astrolabe-expeditions/LittObs_CTD/docs/README.md

# LittObs | Sonde CTD

## Description

Le programme LittObs d’Astrolabe Expeditions a pour objectif de déployer un réseau d’observatoires océanographiques littoraux en impliquant les habitants du territoire. Ces observatoires sont des stations de mesure lestées au fond de l’eau qui enregistrent les paramètres physiques, chimiques ou biologiques de la colonne d'eau. Les premiers capteurs seront chargés de mesurer la conductivité, la température et la pression de l'eau (CTD) afin de déterminer la salinité de l'eau.

## Partenaires

* [LOCEAN](https://www.locean.ipsl.fr/) (IRD/Sorbonne Université)
* [LOPS](https://www.umr-lops.fr/) (CNRS/Ifremer/IRD/IUEM/UBO)
* [AMURE](https://www.umr-amure.fr/) (IUEM/UBO)
* [Les Fabriques du Ponant](https://www.lesfabriquesduponant.net/)
* Amicale des plaisanciers des Marinas de Brest (APMB)
* Association des plaisanciers de Sainte-Anne du Portzic (APSAP)
* [Réseau Initiatives des Eco-explorateurs de la Mer](https://riem-asso.com/) (RIEM)
* [Fondation du Crédit Mutuel Alliance Fédérale](https://fondation.creditmutuelalliancefederale.fr/)
* [Fondation de France](https://www.fondationdefrance.org/)

## Étudier les zones littorales sous l'influence des fleuves

Les zones littorales, directement influencées par les apports fluviaux, sont intéressantes dans l’étude du mélange entre les eaux douces et marines, facteur important de la salinisation des océans, et donc des mouvements des courants marins qui régulent notre climat. De plus, la biodiversité marine et terrestre y est plus dense que sur le reste du littoral, favorisant le développement d’écosystèmes riches et particuliers. Ces zones sont aussi vulnérables puisque soumises à la pression liée à l’activité humaine ainsi que par le changement climatique. Il est donc primordial de surveiller l’évolution de ces écosystèmes à des fins de préservation. L’opportunité de développer des capteurs à bas coût, construits et déployés localement pourrait augmenter significativement la compréhension de ces mélanges entre continents et mers, et d’apporter des jeux de données accessibles sur la courantologie côtière permettant d’anticiper les effets du réchauffement climatique.

## Matériel&#x20;

| Sous-total ligne de mouillage avec LAMOS (TTC) | | | 544,02 € |
| --- | --- | --- | --- |
| [Caisson CTD](./module-2-caisson-ctd.md) | | | |
| 0,25 | [Plaque plexiglass épais. 10mm transparent, L. 50cm x H. 30cm](https://plaqueplastique.fr/product/plaque-plexiglass-xt-10mm-transparent/) | 21,59 €  | 5,40 € |
| 2 | [Joint torique, Ø int. 52mm, Ø ext. 60mm, épais. 4mm](http://fr.rs-online.com/web/p/joints-et-joints-toriques/1965129) | 0,45 € | 0,90 € |
| 1 | [Joint torique, Ø int. 12mm, Ø ext. 16mm, épais. 2mm](https://fr.rs-online.com/web/p/joints-et-joints-toriques/1964869?gb=a) | 0,10 € | 0,10 € |
| 3 | [Écrou borgne M4, inox A4 316](https://www.vis-express.fr/ecrou-borgne-inox-a4-din-1587-vs0100/37773-2559648-ecrou-borgne-m4-inox-a4.html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) | 0,04 € | 0,11 € |
| 3 | [Écrou à oreilles M4, inox A4 316](https://fr.rs-online.com/web/p/ecrous-a-oreilles/2484315?gb=s) | 0,79 € | 2,36 € |
| 2 | [Vis à tête cylindrique pozi M3 x L. 20mm, inox A4 316](https://fr.rs-online.com/web/p/vis-a-metaux/0190478?gb=s) | 0,13 € | 0,25 € |
| 6 | [Vis à tête cylindrique pozi M3 x L. 10mm, inox A4 316](https://fr.rs-online.com/web/p/vis-a-metaux/0190440?gb=s) | 0,10 € | 0,62 € |
| 1 | [Tige filetée M4 x L. 1m, inox A4 316](https://www.vis-express.fr/tige-filetee-longueur-1-metre-inox-a4-din-975vs3347vs0104/21608-tige-filetee-m4-longueur-1-metre-inox-a4.html) | 1,92 € | 1,92 € |
| 1 | [Tube PVC PN16, Ø ext. 63mm, épais. 4,7mm](https://connexion-pression.com/tubes-rigides-pvc-pression/63-915-tube-d-63-pn16-pvc-pression.html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) | 12,31 €  | 12,31 € |
| 4 | [Colliers de serrage nylon 4,8mm x 300mm](https://fr.rs-online.com/web/p/serre-cables/0233487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) | 0,15 € | 0,58 € |
| 0,1 | [Filament 3D PETG 1kg noir 1,75 mm](https://eu.store.bambulab.com/fr/products/petg-hf?id=49068714754396) | 25,99 €  | 2,60 € |
| 2 | [Vis à tête hexagonale M8 x L. 40mm, inox A4 316](https://www.vis-express.fr/vis-metaux-tete-hexagonale-th-inox-a4-din-933/20979-2322303-vis-metaux-tete-hexagonale-th-m8x40-inox-a4.html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..\&gclid=Cj0KCQiA_NC9BhCkARIsABSnSTarAGtmwjGLn0YNz8O_tkDtvD-51bRM3g7qLIVmRQDK-fGx2-1gUb4aAhp9EALw_wcB#/conditionnement-30_pieces) | 1,56 € | 3,12 € |
| 0,1 | [Graisse silicone pour joints toriques](https://fr.rs-online.com/web/p/graisses/0494124) | 18,23 €  | 1,82 € |
| | Imprimante 3D (pour support PCB et fixation CTD) | | |
| | Découpeuse laser | | |
| | Perceuse à colonne (avec foret à acier) | | |
| | Lime à métaux | | |
| | Scie sauteuse (avec lame à métaux) | | |
| | Tarauds | | |
| | Scie circulaire | | |
| | Affleureuse | | |
| [PCB CTD](./module-1-carte-electronique-pcb.md) | | | |
| 1 | [PCB à imprimer](https://jlcpcb.com/) | 3,00 € | 3,00 € |
| 1 | [Mini Conductivity Probe K 1.0](https://sensorsandprobes.com/products/mini-conductivity-probe-k-1-0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) | 109,95 € | 109,95 € |
| 1 | [Electrically Isolated EZO™ Carrier Board](https://sensorsandprobes.com/products/electrically-isolated-ezo%E2%84%A2-carrier-board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) | 32,95 €  | 32,95 € |
| 1 | [EZO™ Conductivity Circuit](https://sensorsandprobes.com/products/ezo%E2%84%A2-conductivity-circuit?_pos=1&_sid=2aabb4a1c&_ss=r) | 67,95 €  | 67,95 € |
| 1 | [Booster 5 V U1V11F5](https://www.gotronic.fr/art-booster-5-v-u1v11f5-21751.htm) | 8,80 € | 8,80 € |
| 1 | BlueRobotics Celsius Fast-Response, ±0.1°C Temperature Sensor (I2C) | 78,66 €  | 78,66 € |
| 1 | [BlueRobotics Bar30 High-Resolution 300m Depth/Pressure Sensor](https://eu.robotshop.com/products/bar30-high-resolution-300m-depth-pressure-sensor-r2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) | 98,18 €  | 98,18 € |
| 1 | [Module FireBeetle ESP32 DFR0478](https://www.gotronic.fr/art-module-firebeetle-esp32-dfr0478-26810.htm) | 13,90 €  | 13,90 € |
| 1 | [Cordon USB micro USB 50cm](https://www.gotronic.fr/art-cordon-50-cm-rs105-33657.htm) | 1,95 € | 1,95 € |
| 1 | [Lecteur de carte micro-SD ADA4682, interface SPI et SDIO, 3,3 Vcc](https://www.gotronic.fr/art-lecteur-de-carte-micro-sd-ada4682-33468.htm) | 4,55 € | 4,55 € |
| 1 | [Carte MicroSDHC 8GB avec adaptateur](https://fr.rs-online.com/web/p/cartes-sd/2835980) | 6,76 € | 6,76 € |
| 1 | [Module RTC I2C DS3231M DFR0641](https://www.gotronic.fr/art-module-rtc-i2c-ds3231m-dfr0641-32243.htm) | 8,25 € | 8,25 € |
| 1 | Pile 3V CR1220 | 1,70 € | 1,70 € |
| 2 | [Batterie 18650 3400mAh 8A (/!\ la référence change régulièrement)](https://www.nkon.nl/fr/samsung-inr18650-35e.html) | 2,29 € | 4,58 € |
| 2 | [Support batterie 18650](https://www.nkon.nl/fr/1x-18650-batterijhouder-met-klemmen-en-losse-draden.html) | 1,09 € | 2,18 € |
| 1 | [Led 5mm verte 2 mA](https://www.gotronic.fr/art-assortiment-de-50-leds-36117.htm) | 0,10 € | 0,10 € |
| 1 | [Résistance 1/4W 47Ω](https://www.gotronic.fr/art-10-resistances-1-4w-47-8486-2561.htm) | 0,02 € | 0,02 € |
| 2 | [Résistance 1/4W 4,7KΩ](https://www.gotronic.fr/art-10-resistances-1-4w-4-7k-8486-300.htm) | 0,02 € | 0,04 € |
| 1 | [Résistance 1/4W 10KΩ](https://www.gotronic.fr/art-10-resistances-1-4w-10k-8486-19.htm) | 0,02 € | 0,02 € |
| 1 | [Résistance 1/4W 1KΩ](https://www.gotronic.fr/art-10-resistances-1-4w-1-0k-8486-2574.htm) | 0,02 € | 0,02 € |
| 2 | [Embase pour CI JST, GH, 4 pôles, 1,25mm, 1,0A, Droit](https://fr.rs-online.com/web/p/embases-circuits-imprimes/7521769P) | 0,39 € | 0,77 € |
| 1 | [Interrupteur ILS 1T avec boîtier (pour la wifi)](https://www.gotronic.fr/art-interrupteur-ils-boitier-19991.htm) | 1,95 € | 1,95 € |
| 2 | [Aimant rond avec vis](https://www.supermagnete.fr/porte-cables-magnetiques/porte-cable-magnetique-43mm_CMN-43) | 6,98 € | 13,96 € |
| 1 | [Ruban agrippant adhésif](https://www.leroymerlin.fr/produits/quincaillerie/corde-sangle-sandow-chaine-cable/sangle-courroie-bande-agrippante/bande-agrippante/10-rubans-agrippants-adhesifs-in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) | 0,39 € | 0,39 € |
| 1 | [Transistor 2N3904](https://www.gotronic.fr/art-transistor-2n3904-1561.htm) | 0,15 € | 0,15 € |
| 1 | [Commutateur à glissière, 1RT, Verrouillable, 5A, 28 Vcc](https://fr.rs-online.com/web/p/interrupteurs-a-glissiere/7347296) | 7,00 € | 7,00 € |
| 1 | [Connecteurs mâles, 2,54mm](https://www.gotronic.fr/art-connecteur-he14-mh100-4-33565.htm) | 0,65 € | 0,65 € |
| 2 | [Connecteurs femelles FH1X18 18 contacts, 2,54mm](https://www.gotronic.fr/art-connecteur-fh1x18-35647.htm) | 1,50 € | 3,00 € |
| 1 | [Connecteurs femelles FH1X7 7 contacts, 2,54mm](https://www.gotronic.fr/art-connecteur-fh1x7-22733.htm) | 0,65 € | 0,65 € |
| 1 | [LED UVC](https://fr.rs-online.com/web/p/led-uv/2102019) | 1,69 € | 1,69 € |
| 2 | [Connecteur NSK254-2 mâle](https://www.gotronic.fr/art-connecteur-nsk254-2-15394.htm) | 0,08 € | 0,16 € |
| 2 | [Résistance 1/4W 220Ω](https://www.gotronic.fr/art-10-resistances-1-4w-220-8486-2568.htm) | 0,02 € | 0,04 € |
| 1 | [Booster 12V U3V12F12](https://www.gotronic.fr/art-booster-12-v-u3v12f12-21752.htm) | | 0,00 € |
| 1 | [Condensateur céramique 47pf](https://www.gotronic.fr/art-condensateur-ceramique-47-pf-3182.htm) | 0,10 € | 0,10 € |
| 1 | [Condensateur céramique 1nF](https://www.gotronic.fr/art-condensateur-ceramique-1-0-nf-3198.htm) | 0,10 € | 0,10 € |
| 1 | [Condensateur céramique 100nF](https://www.gotronic.fr/art-condensateur-ceramique-100-nf-3215.htm) | 0,20 € | 0,20 € |
| | Fer à souder | | |
| | Fer à dessouder | | |
| | Pince coupante | | |
| **Sous-total CTD (TTC)** | | | **506,46 €** |
