astrolabe-expeditions/LittObs_CTD/docs/SUMMARY.md

# Table of contents

* [LittObs | Sonde CTD](README.md)
* [Module 1 : Carte électronique PCB](module-1-carte-electronique-pcb.md)
* [Module 2 : Caisson CTD](module-2-caisson-ctd.md)
* [Module 3 : Programmation](module-3-programmation.md)
* [Module 4 : Mise en route](module-4-mise-en-route.md)
