astrolabe-expeditions/LittObs_CTD/docs/module-3-programmation.md

# Module 3 : Programmation

Le **code** se trouve sur : [https://github.com/CedricCourson/LittObs](https://github.com/CedricCourson/LittObs)<br>

> **Etapes de construction :**
>
> 1. Installer le driver CH340/CH341
> 2. Installer Arduino IDE
> 3. Installer la carte ESP32 Firebeetle
> 4. Installer les librairies

**1. Installer le driver CH340 ou CH341**

* Si vous utilisez un Mac ou un PC sous windows, suivez le lien suivant et suivez les instructions : [https://cdn.sparkfun.com/assets/learn\_tutorials/8/4/4/CH341SER.EXE](https://cdn.sparkfun.com/assets/learn_tutorials/8/4/4/CH341SER.EXE)
* Si vous utilisez Linux, le module est déjà installé (si vous rencontrez des problèmes, vérifiez avec dmesg qu'il n'y a pas un autre driver qui cause des incompatibilités comme brltty)

<br>

**2. Installer Arduino**

* Télécharger le logiciel Arduino : [https://www.arduino.cc/en/software](https://www.arduino.cc/en/software)
* Suivre les instructions d'installation [https://docs.arduino.cc/software/ide-v2/tutorials/getting-started/ide-v2-downloading-and-installing](https://docs.arduino.cc/software/ide-v2/tutorials/getting-started/ide-v2-downloading-and-installing)

<br>

**3. Installer la carte ESP32 Firebeetle**

* dans le menu Files > Preferences, ajouter l'URL suivant dans "Additional board manager" et cliquer sur OK : [https://raw.githubusercontent.com/espressif/arduino-esp32/gh-pages/package\_esp32\_index.json
  <br>](https://raw.githubusercontent.com/espressif/arduino-esp32/gh-pages/package_esp32_index.json)

\
<br>

* Dans le menu Tools > Board > Boards manager : chercher ESP32
* Installer "esp32 _by Espressif Systems_" library<br>

**4. Vérification avec un code simple pour faire clignoter une LED**&#x20;

* Brancher votre carte ESP32 à l'ordinateur
* Sélectionner FireBeetle-ESP32 pour le port de communication (COM...) sur lequel vous l'avez branché (COM... correspond au nom du port USB  de votre ordinateur)
* 
* Coller le code suivant dans la fenêtre de travail et téléversez le sur l'ESP32 :

> <pre class="language-arduino"><code class="lang-arduino">// Ceci est un commentaire
> // Port de la LED
> int led = 2;
> 
> void setup() {
>     // put your setup code here, to run once:
>     // Permet d'activer la communication avec le terminal (Serial Monitor), réglé lui aussi sur 115200
>     Serial.begin(115200);
>     // Affichage dans la console
>     Serial.println("Coucou ! ");
>     // Active le mode OUTPUT pour le port de la LED
> <strong>    pinMode(led, OUTPUT);
> </strong><strong>    // Eteint la LED
> </strong>    digitalWrite(led, LOW);
> }
> 
> void loop() {
>     // put your main code here, to run repeatedly:
>     Serial.println("Start boucle");
>     for (int i=0; i&#x3C;15; i++){
>         // Allume la LED
>         digitalWrite(led, HIGH);
>         // Attend 200 ms
>         delay(200);
>         // Eteint la LED
>         digitalWrite(led, LOW);
>         // Attend 200 ms
>         delay(200);
>         }
>     delay(1000);
> }
> </code></pre>

5. **Installer les librairies**

* Télécharger le zip du github SensOcean où se trouve un dossier "Librairies" contenant toutes les librairies nécessaires : [https://github.com/astrolabe-expeditions/SensOcean](https://github.com/astrolabe-expeditions/SensOcean)
* Placer les fichiers sur votre ordinateur, dans Document, créer un dossier Arduino et déposez y les librairies

\
\_\_\_\_\_\_\_\_\_\_\_\_\_\_\_\_\_\_\_\_\_\_\_\_\_\_\_\_\_\_\_\_\_\_\_\_\_\_\_\_\_\_\_\_\_\_\_\_\_\_\_\_\_\_\_\_\_\_\_\_\_\_\_\_\_\_\_\_\_\_\_\_\_\_\_\_\_\_\_\_\_\_\_\_\_\_\_\_\_\_\_\_

## Test

### 1. Hardware

**Vérifier les soudures**

* Vérifier à l'aide d'un multimètre que les soudures ne se touchent pas (notamment les transistors qui ont des pattes très rapprochées)

**Vérifier le bon fonctionnement du module EZO (petit module vert sur lequel on vient connecter la sonde de conductimétrie)**

*   Mettre la carte sous tension, et vérifier que la petite LED du module EZO (module auquel on relie la sonde) clignote. Si ce n'est pas le cas :

    * Vérifier qu'il y a bien une tension de 5V entre la borne VCC et la borne GND du module violet. Si ce n'est pas le cas, c'est probablement le voltage booster qui n'est pas bon (le petit module muni d'une bobine se trouvant sous la carte ESP). Une solution de secours consiste à :

    soit alimenter directement le module violet avec la sortie 3.3V de la carte ESP, soit à faire un court circuit entre la première et la troisième patte du module voltage booster.

**VÉRIFIER QUE LE MODULE DE CONDUCTIMÉTRIE EZO EST BIEN CONFIGURÉ**

* Par défaut, le capteur communique en UART. Notre programme utilise le protocole I2c pour communiquer avec. Vous savez qu'il est en UART si le module vert clignote en vert puis bleu clair. Il clignote seulement en bleu foncé s'il est en I2c.
* Pour procéder au changement, munissez vous d'une alimentation stabilisée 5V (une Arduino ou une alimentation de laboratoire), et de 3 fils de connection.
* Détachez le module vert du module violet et branchez-le de la sorte :

\
<br>

* Le LED s'allume en bleu = c'est bon !
* Remettez le module vert sur le module violet (dans le bon sens !)

Lien de la doc : [https://files.atlas-scientific.com/EC\_EZO\_Datasheet.pdf](https://files.atlas-scientific.com/EC_EZO_Datasheet.pdf)

### 2. Software

**1. Télécharger le PROJET**

* Télécharger le dossier du projet sur github : [https://github.com/CedricCourson/LittObs](https://github.com/CedricCourson/LittObs)
* Dézipper le dossier

<br>

**2. Configurer la carte SD**

Si la sonde n'a pas encore de carte SD

* Prendre une carte microSD de 8Go
* L'ouvrir sur un PC
* La formater en FAT32

<br>

**3. Configurer la sonde**

* Copier coller le fichier `config_MODELE.txt` sur la carte SD
* Renommer le fichier en `config.txt`
* Les première lignes expliquent chaque paramètre. Une fois que vous en avez pris connaissance, supprimer ces lignes explicatives. Il ne reste plus que :

```
id_logger=OSOCTD022;
```

```
delay_batch=5;
```

```
number_measures=3;
```

```
debug_mode=1;
```

```
led_mode=1;
```

* Changer le paramètre OSOCTD022 pour qu'il corresponde au nom de la sonde (par exemple : AELO007)
* Laisser les autres paramètres tels quels

<br>

**4. Vérifier que l'ESP communique**

* Ouvrir le fichier Module\_CTD.ino avec l'IDE Arduino
* Connecter le ESP32 en USB et sélectionner la carte FireBeetle ESP32 pour le bon port COM
* Téléverser le code sur la carte
* L'ESP est censé renvoyer quelque chose comme :

```
ets Jun 8 2016 00:22:57
```

```
rst:0x1 (POWERON_RESET),boot:0x1b (SPI_FAST_FLASH_BOOT)
```

```
flash read err, 1000
```

```
ets_main.c 371
```

```
ets Jun 8 2016 00:22:57
```

```
rst:0x10 (RTCWDT_RTC_RESET),boot:0x1b (SPI_FAST_FLASH_BOOT)
```

```
configsip: 0, SPIWP:0xee
```

```
clk_drv:0x00,q_drv:0x00,d_drv:0x00,cs0_drv:0x00,hd_drv:0x00,wp_drv:0x00
```

```
mode:DIO, clock div:1
```

```
load:0x3fff0018,len:4
```

```
load:0x3fff001c,len:1044
```

```
load:0x40078000,len:8896
```

```
load:0x40080400,len:5816
```

```
entry 0x400806ac
```

```
Error: Unable to communicate with BQ27441.
```

```
Check wiring and try again.
```

```
(Battery must be plugged into Battery Babysitter!)
```

```
Init failed!
```

```
Are SDA/SCL connected correctly?
```

```
Blue Robotics Bar30: White=SDA, Green=SCL
```

**5. Vérifier que le module de conductimétrie EZO est bien configuré**

* Par défaut, le capteur communique en UART. Notre programme utilise le protocole I2c pour communiquer avec. Vous savez qu'il est en UART si le module vert clignote en vert puis bleu clair. Il clignote seulement en bleu foncé s'il est en I2c.
* Pour procéder au changement, munissez vous d'une alimentation stabilisée 5V (une Arduino ou une alimentation de laboratoire), et de 3 fils de connection.
* Détachez le module vert du module violet et branchez-le de la sorte :



* Le LED s'allume en bleu, c'est bon !
* Remettez le module vert sur le module violet (dans le bon sens !)

Lien de la doc : [https://files.atlas-scientific.com/EC\_EZO\_Datasheet.pdf](https://files.atlas-scientific.com/EC_EZO_Datasheet.pdf)<br>

**6. Vérifier que les capteurs communiquent avec l'ESP**

...<br>

**7. Vérifier que l'alimentation sur batterie fonctionne**

...<br>

**8. Tester le WIFI**

* Mettre les fichiers du dossier Server\_Files sur la carte SD (attention, bien les mettre à la racine, pas dans des dossiers)
* Ouvrir et téléverser le fichier `Module_CTD_Wifi.ino` avec l'IDE Arduino

#### Interface de gestion de l'instrument

L'instrument est doté d’une interface web permettant de lire et récupérer le fichier de données et le fichier de configuration. Pour y accéder il suffit de placer un aimant devant l’interrupteur ILS au moment de l’allumage.\
Dans ce cas l’ESP32 démarre en mode serveur Web, et peut y accéder simplement via wifi depuis n’importe quel appareil (ordi, smartphone, tablette…).\
L’ESP32 démarre un serveur wifi au SSID (nom) : _LittObs-Instrument_\
Ensuite il suffit d’ouvrir un navigateur web et d’entrer l’adresse : 192.168.1.4\
On accéde alors à une page web permettant de gérer l’instrument.\
**Menu principal**\
Page web de l’interface (download data file et config file et accès au menu)\
\
\
**Données**\
Page de gestion des données permettant actuellement de lire directement les données, télécharger, ou tout effacer.\
\
\
\
**Configuration de l’instrument**\
Permet actuellement de synchroniser l’horloge RTC avec l’ordinateur (l’objectif : étalonner les capteurs et réglage instrument).

#### Visualisation et téléchargement des données
