astrolabe-expeditions/LittObs_CTD/hardware/pcbs/PCB_CTD_v2.3.png

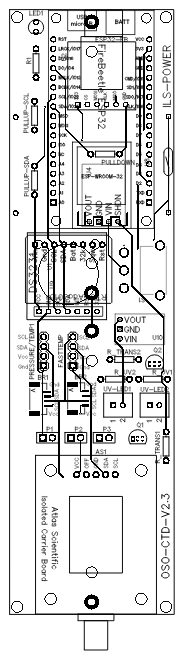
hardware/pcbs/PCB_CTD_v2.3.png
