astrolabe-expeditions/LittObs_CTD/hardware/pcbs/Schematic_PCB_CTD_v2.3.png

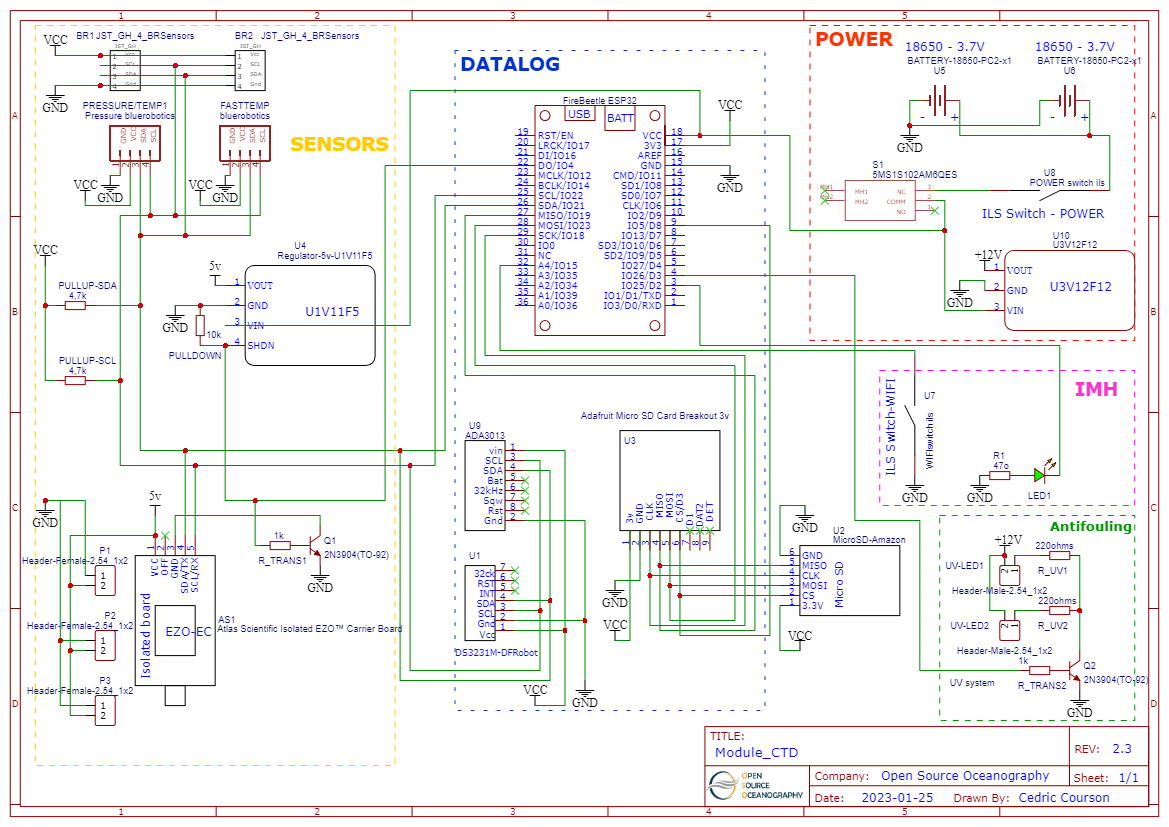
hardware/pcbs/Schematic_PCB_CTD_v2.3.png
