astrolabe-expeditions/LittObs_CTD/hardware/enclosures/Fixation_complete.3mf

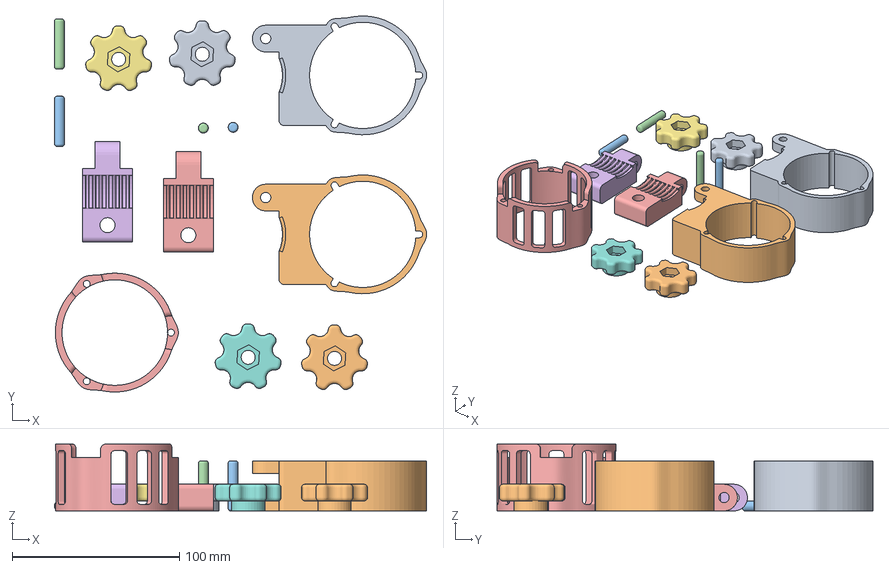
[picture p19: CAD file, 2026-02-24]
hardware/enclosures/Fixation_complete.3mf
222.6 x 224.7 x 40.0 mm
fixation.stl x 2
Charnière.stl x 4
capot-fermeture.stl x 2
molette.stl x 4
Cache-Capteur v5.stl
