astrolabe-expeditions/LittObs_CTD/hardware/enclosures/Fixation_charniere.stl

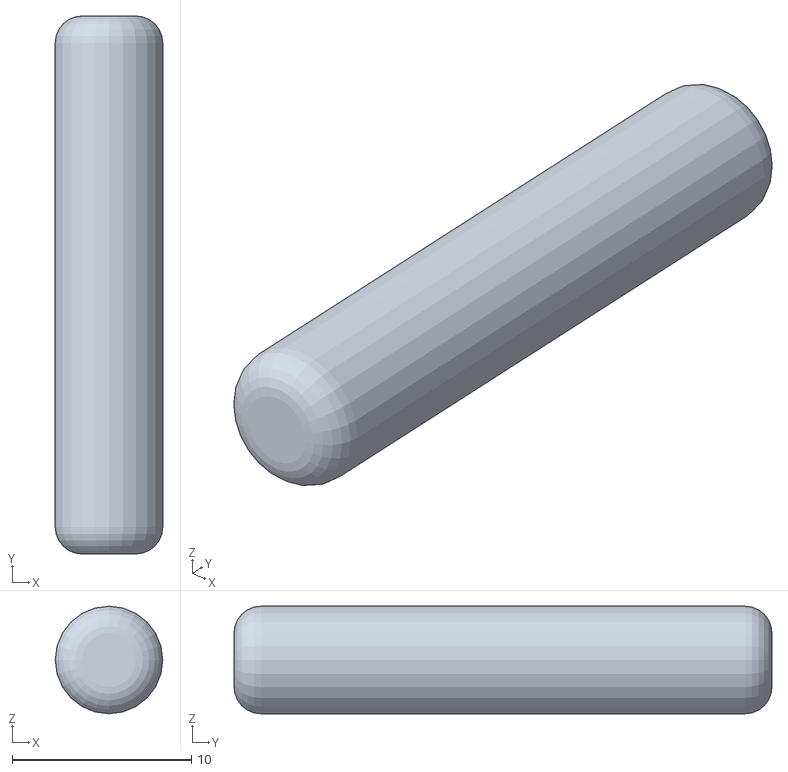
[picture p20: CAD file, 2026-02-24]
hardware/enclosures/Fixation_charniere.stl
6.00 x 30.0 x 6.00
