astrolabe-expeditions/LittObs_CTD/hardware/enclosures/PCB_Holder.stl

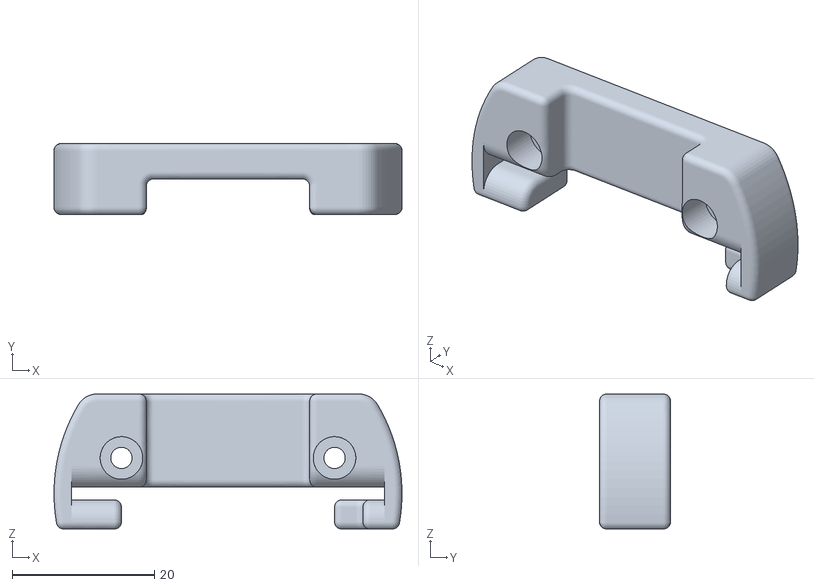
[picture p21: CAD file, 2026-02-24]
hardware/enclosures/PCB_Holder.stl
49.0 x 10.0 x 19.0
