astrolabe-expeditions/LittObs_CTD/hardware/enclosures/Fixation_corps.stl

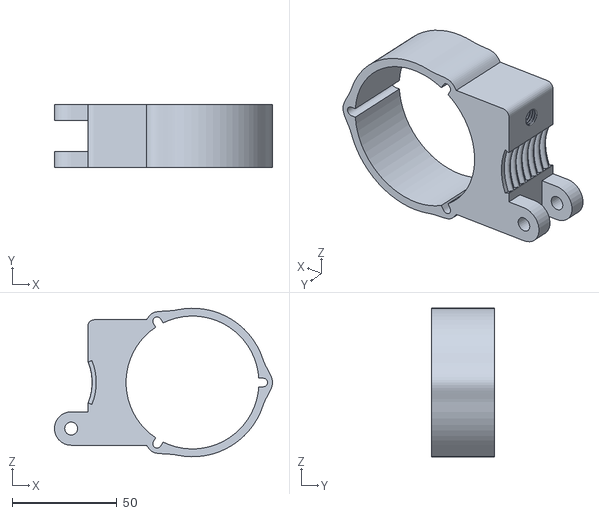
[picture p22: CAD file, 2026-02-24]
hardware/enclosures/Fixation_corps.stl
104.2 x 30.0 x 71.0
