astrolabe-expeditions/LittObs_CTD/hardware/enclosures/Sensor_Protection.stl

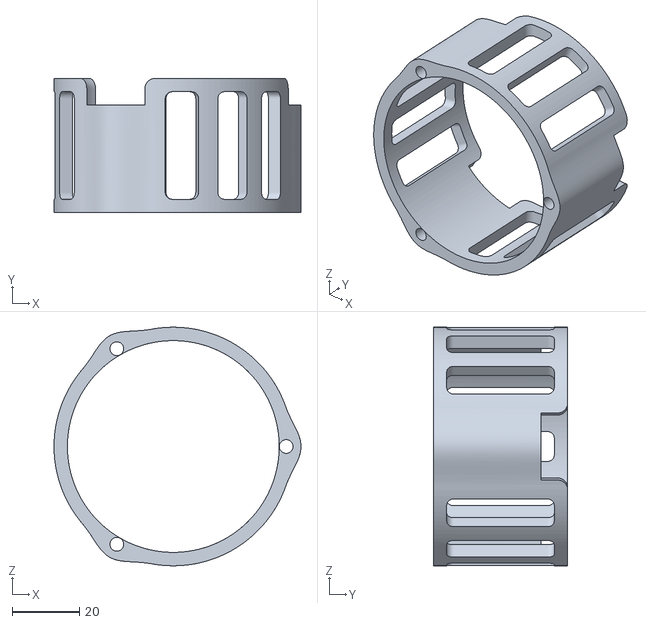
[picture p23: CAD file, 2026-02-24]
hardware/enclosures/Sensor_Protection.stl
73.5 x 40.0 x 71.0
