astrolabe-expeditions/LittObs_CTD/hardware/enclosures/Fixation_capot_fermeture.stl

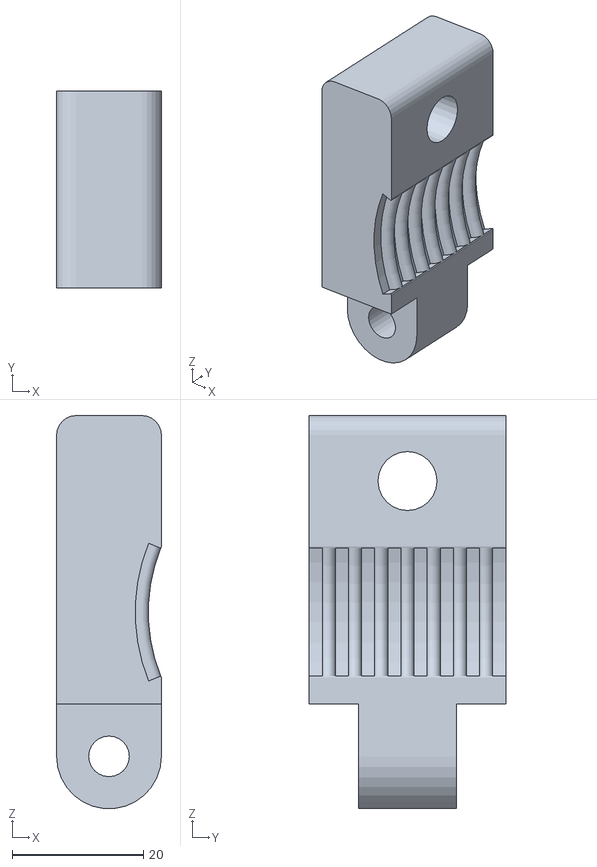
[picture p24: CAD file, 2026-02-24]
hardware/enclosures/Fixation_capot_fermeture.stl
16.0 x 30.0 x 60.0
