astrolabe-expeditions/LittObs_CTD/hardware/enclosures/Fixation_molette.stl

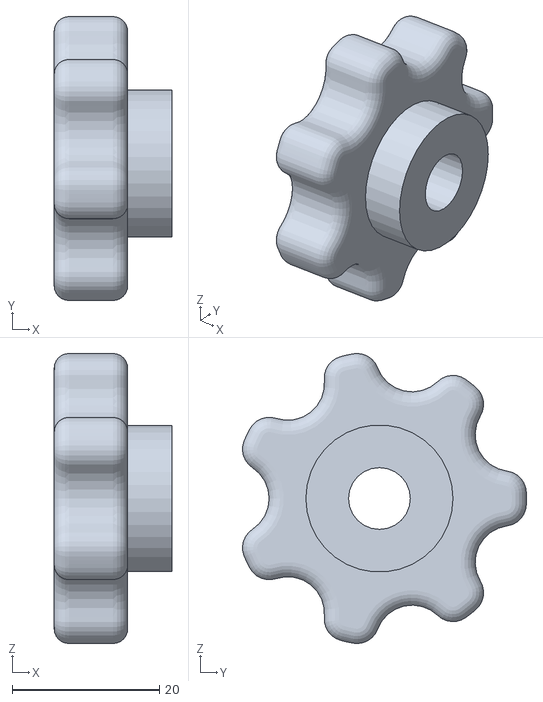
[picture p25: CAD file, 2026-02-24]
hardware/enclosures/Fixation_molette.stl
16.0 x 38.6 x 39.4
