astrolabe-expeditions/LittObs_CTD/hardware/enclosures/PCB_Support.stl

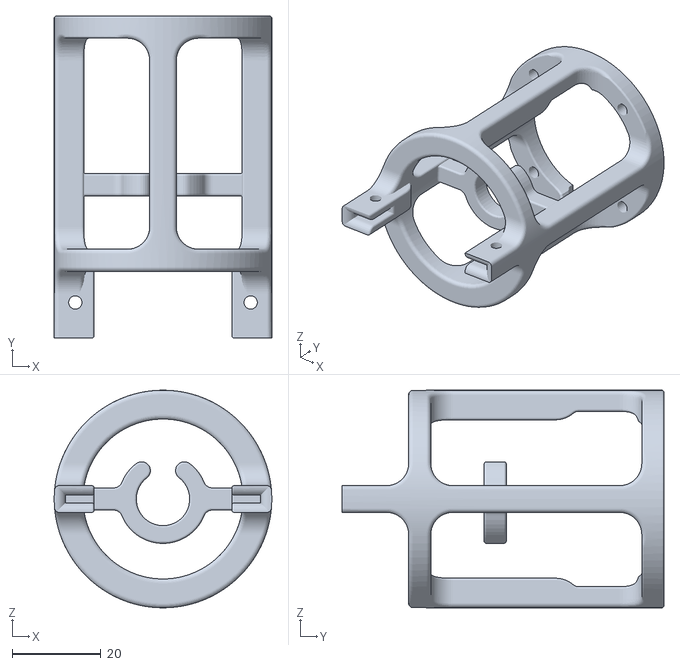
[picture p26: CAD file, 2026-02-24]
hardware/enclosures/PCB_Support.stl
49.0 x 72.5 x 49.0
