astrolabe-expeditions/LittObs_CTD/hardware/pcbs/GERBER_PCB_CTD_v2.3/How-to-order-PCB.txt

How to Order PCB

Please refer to:
https://docs.easyeda.com/en/PCB/Order-PCB
