astrolabe-expeditions/LittObs_CTD/software/firmware/Individual_tests/OSO_tools-main/EC_Test_Calib/EC_Test_Calib.ino

/* Code for reading and sending command to EZO-RTD from Atlas Scientific
Use for : 
- Read temperature,
- Test EZO_RTD device
- Calibration

Instruction : 
- Change the pin number for startpin et ledpin if needed (and comment or uncomment pin setup in void setup)
- upload the code on device and read and send command from serial monitor
*/

// pin declaration if needed
//const int ledpin = XX; 
const int startpin = 4; //4; ou 27 pour SO

#include <Wire.h>                //enable I2C.
#define address 100              //default I2C ID number for EZO EC Circuit.



char computerdata[20];           //we make a 20 byte character array to hold incoming data from a pc/mac/other.
byte received_from_computer = 0; //we need to know how many characters have been received.
byte serial_event = 0;           //a flag to signal when data has been received from the pc/mac/other.
byte code = 0;                   //used to hold the I2C response code.
char ec_data[32];                //we make a 32 byte character array to hold incoming data from the EC circuit.
byte in_char = 0;                //used as a 1 byte buffer to store inbound bytes from the EC Circuit.
byte i = 0;                      //counter used for ec_data array.
int time_ = 570;                 //used to change the delay needed depending on the command sent to the EZO Class EC Circuit.

char *ec;                        //char pointer used in string parsing.
char *tds;                       //char pointer used in string parsing.
char *sal;                       //char pointer used in string parsing.
char *sg;                        //char pointer used in string parsing.

float ec_float;                  //float var used to hold the float value of the conductivity.
float tds_float;                 //float var used to hold the float value of the TDS.
float sal_float;                 //float var used to hold the float value of the salinity.
float sg_float;                  //float var used to hold the float value of the specific gravity.


void setup()                     //hardware initialization.
{
  // pin initialisation
  pinMode(startpin, OUTPUT);
  digitalWrite(startpin, HIGH);
  // pinMode(ledpin, OUTPUT);
  // digitalWrite(ledpin, HIGH);
  delay(1000);

  Serial.begin(115200);            //enable serial port.
  Wire.begin();                  //enable I2C port.
  
}


void serialEvent() {                                                              //this interrupt will trigger when the data coming from the serial monitor(pc/mac/other) is received.
  received_from_computer = Serial.readBytesUntil(13, computerdata, 20);           //we read the data sent from the serial monitor(pc/mac/other) until we see a <CR>. We also count how many characters have been received.
  computerdata[received_from_computer] = 0;                                       //stop the buffer from transmitting leftovers or garbage.
  if(computerdata[0]!='\0'){
    Serial.print("Commande envoyé : ");Serial.println(computerdata);
    serial_event = true;                                                            //set the serial event flag.
  }

}



void loop() {                                                                     //the main loop.
  serialEvent();
  if (serial_event == true) {                                                     //if a command was sent to the EZO device.
    for (i = 0; i <= received_from_computer; i++) {                               //set all char to lower case, this is just so this exact sample code can recognize the "sleep" command.
      computerdata[i] = tolower(computerdata[i]);                                 //"Sleep" ≠ "sleep"
    }
    i=0;                                                                          //reset i, we will need it later 
    if (computerdata[0] == 'c' || computerdata[0] == 'r')time_ = 570;             //if a command has been sent to calibrate or take a reading we wait 570ms so that the circuit has time to take the reading.
    else time_ = 250;                                                             //if any other command has been sent we wait only 250ms.


    Wire.beginTransmission(address);                                            //call the circuit by its ID number.
    
    int i = 0;
    while (computerdata[i] != 0) Wire.write((uint8_t)computerdata[i++]);
    //Wire.write(computerdata);                                                   //transmit the command that was sent through the serial port.
    Wire.endTransmission();                                                     //end the I2C data transmission.


    if (strcmp(computerdata, "sleep") != 0) {                                   //if the command that has been sent is NOT the sleep command, wait the correct amount of time and request data.
                                                                                //if it is the sleep command, we do nothing. Issuing a sleep command and then requesting data will wake the EC circuit.

      delay(time_);                                                             //wait the correct amount of time for the circuit to complete its instruction.

      Wire.requestFrom(address, 32, 1);                                         //call the circuit and request 32 bytes (this could be too small, but it is the max i2c buffer size for an Arduino)
      code = Wire.read();                                                       //the first byte is the response code, we read this separately.

      switch (code) {                           //switch case based on what the response code is.
        case 1:                                 //decimal 1.
          Serial.println("Success");            //means the command was successful.
          break;                                //exits the switch case.

        case 2:                                 //decimal 2.
          Serial.println("Failed");             //means the command has failed.
          break;                                //exits the switch case.

        case 254:                               //decimal 254.
          Serial.println("Pending");            //means the command has not yet been finished calculating.
          break;                                //exits the switch case.

        case 255:                               //decimal 255.
          Serial.println("No Data");            //means there is no further data to send.
          break;                                //exits the switch case.
      }

      while (Wire.available()) {                 //are there bytes to receive.
        in_char = Wire.read();                   //receive a byte.
        ec_data[i] = in_char;                    //load this byte into our array.
        i += 1;                                  //incur the counter for the array element.
        if (in_char == 0) {                      //if we see that we have been sent a null command.
          i = 0;                                 //reset the counter i to 0.
          break;                                 //exit the while loop.
        }
      }

      Serial.println(ec_data);                  //print the data.
      Serial.println();                         //this just makes the output easier to read by adding an extra blank line 
    }
    serial_event = false;                      //reset the serial event flag.

    //if (computerdata[0] == 'r') string_pars(); //uncomment this function if you would like to break up the comma separated string into its individual parts.
  }

}
void string_pars() {                  //this function will break up the CSV string into its 4 individual parts. EC|TDS|SAL|SG.
                                      //this is done using the C command “strtok”.

  ec = strtok(ec_data, ",");          //let's pars the string at each comma.
  tds = strtok(NULL, ",");            //let's pars the string at each comma.
  sal = strtok(NULL, ",");            //let's pars the string at each comma.
  sg = strtok(NULL, ",");             //let's pars the string at each comma.

  Serial.print("EC:");                //we now print each value we parsed separately.
  Serial.println(ec);                 //this is the EC value.

  Serial.print("TDS:");               //we now print each value we parsed separately.
  Serial.println(tds);                //this is the TDS value.

  Serial.print("SAL:");               //we now print each value we parsed separately.
  Serial.println(sal);                //this is the salinity value.

  Serial.print("SG:");               //we now print each value we parsed separately.
  Serial.println(sg);                //this is the specific gravity.
  Serial.println();                  //this just makes the output easier to read by adding an extra blank line 
    
  //uncomment this section if you want to take the values and convert them into floating point number.
/*  
    ec_float=atof(ec);
    tds_float=atof(tds);
    sal_float=atof(sal);
    sg_float=atof(sg);
*/  
}
