astrolabe-expeditions/LittObs_CTD/(commit log)

2026-02-23 GITBOOK-29: Mise à jour de la documentation pour la procédure d'installation de l'ESP32
2026-02-24 refactor: Move config file into software/firmware
    [config_MODELE.txt]
2026-02-24 refactor: Remove archive version of code This version could be found with git history in the future.
    [config_MODELE.txt]
2026-02-24 refactor: Delete LO_empty_sd as it is a copy of server code
    [config.txt]
2026-02-24 refactor: Delete WIP code for Arduino The modification will be added in a separate PR for history.
2026-02-24 feat: Add hardware files
    [Fixation_capot_fermeture.stl, Fixation_charniere.stl, Fixation_complete.3mf, Fixation_corps.stl, Fixation_molette.stl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]
2026-10-01 docs(gitbook-44): descriptif pcb
